TheMahaanOne/fsae-aero-2026/images/cfd/volume_mesh_side.jpg

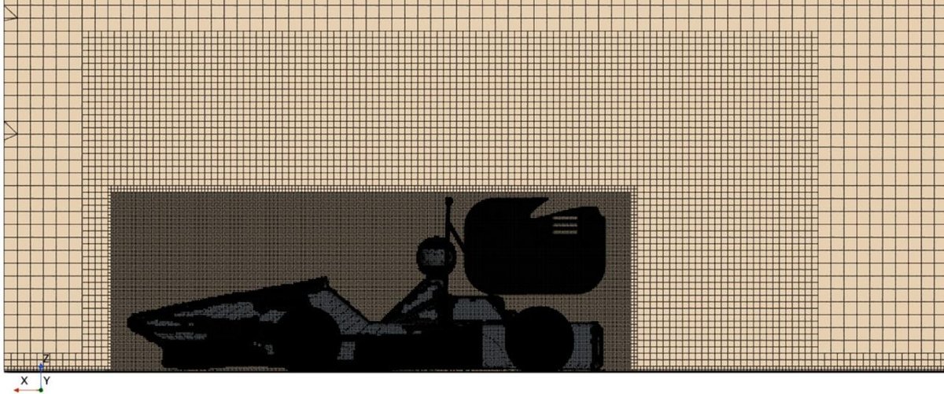
images/cfd/volume_mesh_side.jpg
