TheMahaanOne/fsae-aero-2026/images/rear_wing_corrugated_element.jpg

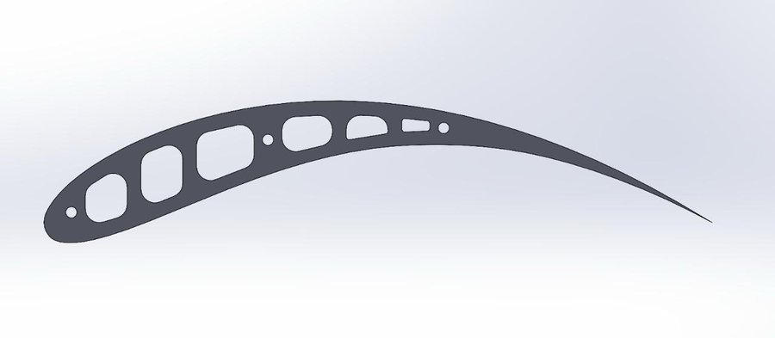
images/rear_wing_corrugated_element.jpg
