TheMahaanOne/fsae-aero-2026/images/sweeps/front_wing_cd_pitch.jpg

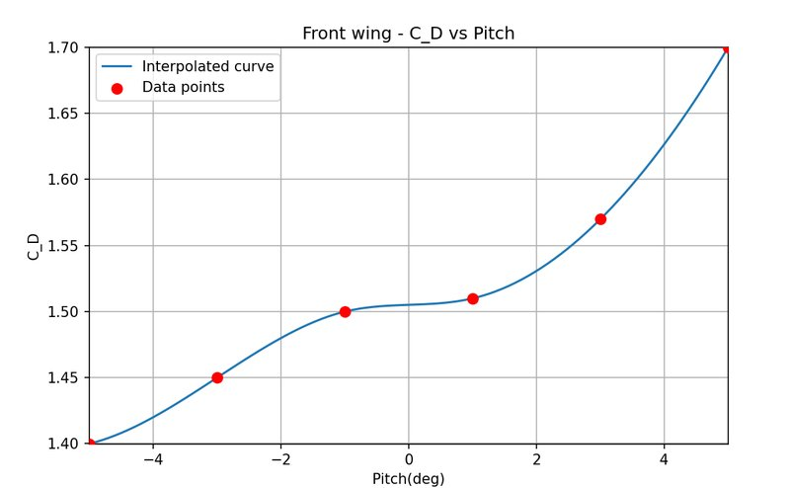
images/sweeps/front_wing_cd_pitch.jpg
