TheMahaanOne/fsae-aero-2026/cad/full_car.stl

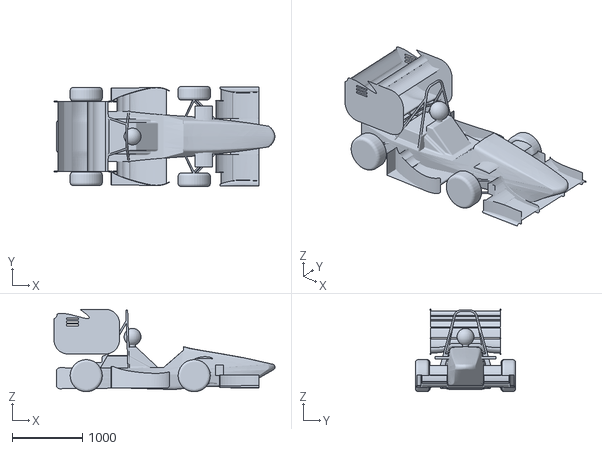
[picture p39: CAD file, 2026-10-17]
cad/full_car.stl
3136.6 x 1420.0 x 1170.0
