TheMahaanOne/fsae-aero-2026/cad/side_wings.stl

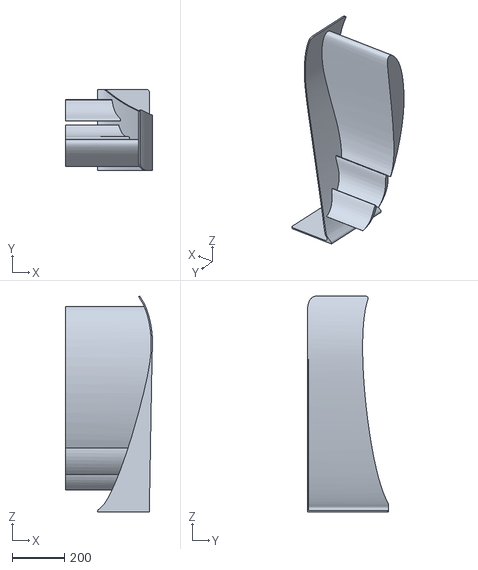
[picture p40: CAD file, 2026-10-17]
cad/side_wings.stl
332.7 x 310.0 x 825.1
