TheMahaanOne/fsae-aero-2026/cad/bluff_body.stl

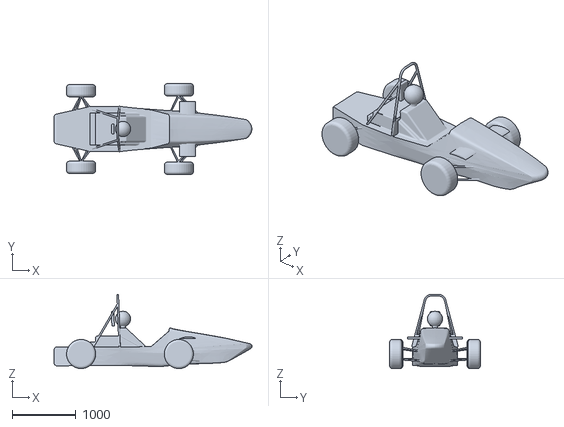
[picture p41: CAD file, 2026-10-17]
cad/bluff_body.stl
3103.6 x 1420.0 x 1162.0
