TheMahaanOne/fsae-aero-2026/cad/rear_wing.stl

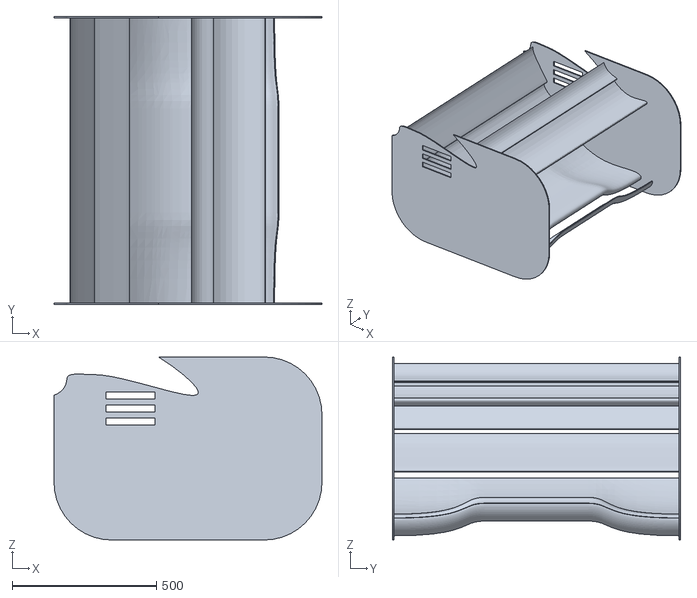
[picture p42: CAD file, 2026-10-17]
cad/rear_wing.stl
930.0 x 1000.0 x 635.0
