TheMahaanOne/fsae-aero-2026/cad/front_wing.stl

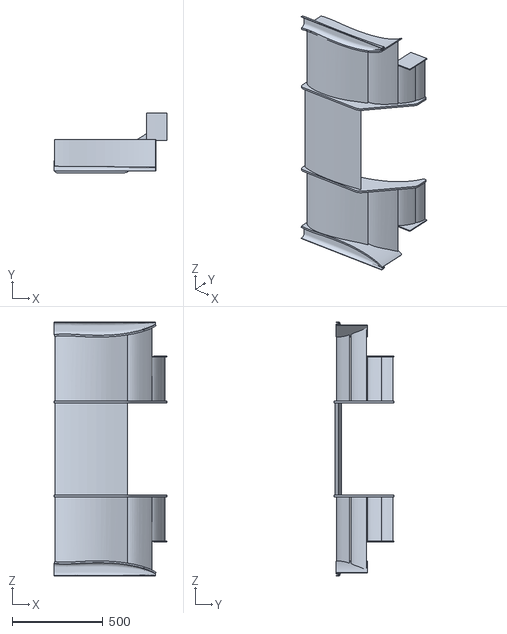
[picture p43: CAD file, 2026-10-17]
cad/front_wing.stl
621.5 x 330.0 x 1400.6
