TheMahaanOne/fsae-aero-2026/(list of files, cad)

Other CAD files:
cad/bluff_body.x_t
cad/front_wing.x_t
cad/full_car.x_t
cad/rear_wing.x_t
cad/side_wings.x_t
