TheMahaanOne/fsae-aero-2026/images/manufacturing/female_mould_for_front_wing_flaps.jpg

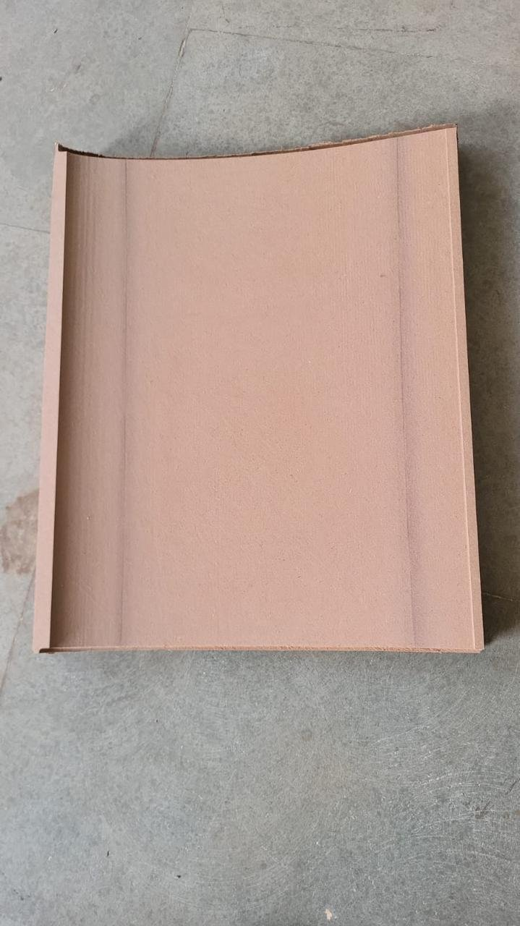
images/manufacturing/female_mould_for_front_wing_flaps.jpg
