TheMahaanOne/fsae-aero-2026/images/manufacturing/filler_and_putty_to_smoothen_female_mould_2.jpg

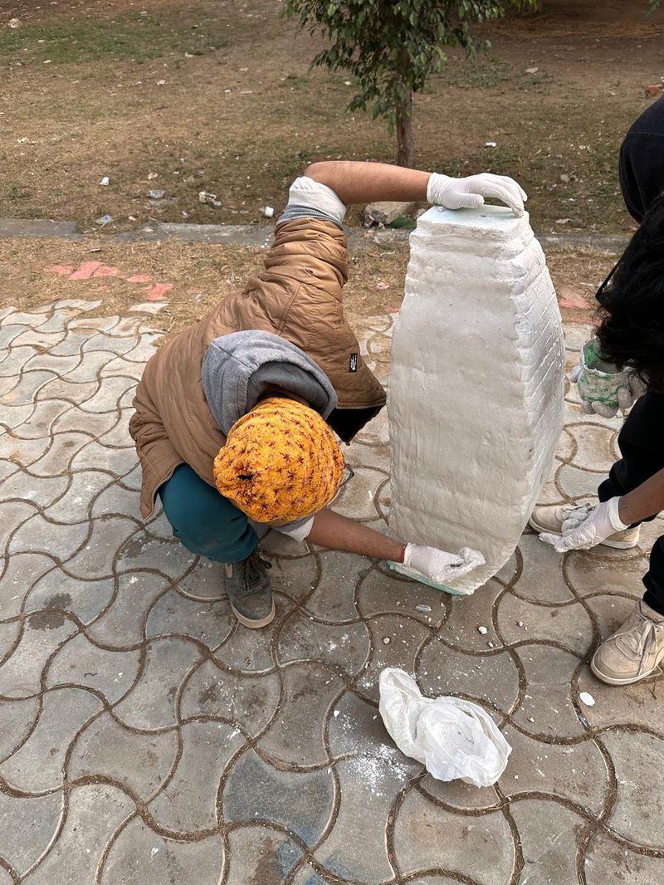
images/manufacturing/filler_and_putty_to_smoothen_female_mould_2.jpg
