TheMahaanOne/fsae-aero-2026/images/manufacturing/final_nosecone_pattern.jpg

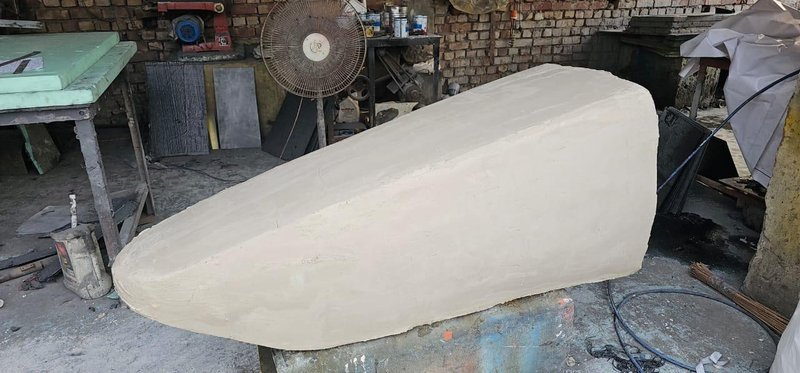
images/manufacturing/final_nosecone_pattern.jpg
