TheMahaanOne/fsae-aero-2026/images/manufacturing/vacuum_drawn_checking_for_leaks.jpg

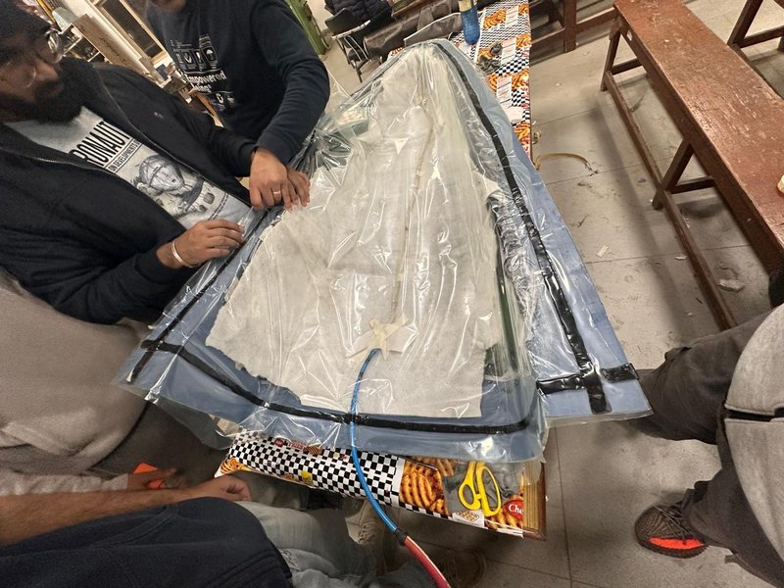
images/manufacturing/vacuum_drawn_checking_for_leaks.jpg
