TheMahaanOne/fsae-aero-2026/images/car/in_the_workshop_between_testing.jpg

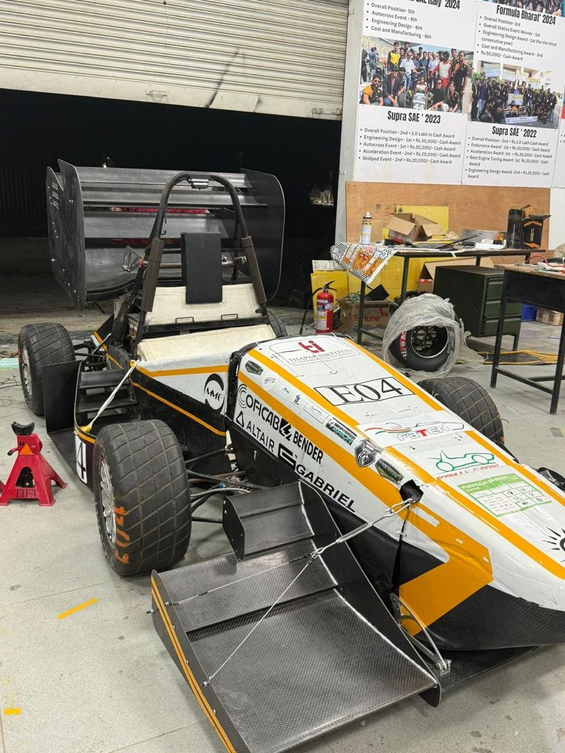
images/car/in_the_workshop_between_testing.jpg
