TheMahaanOne/fsae-aero-2026/images/manufacturing/test_fitting.jpg

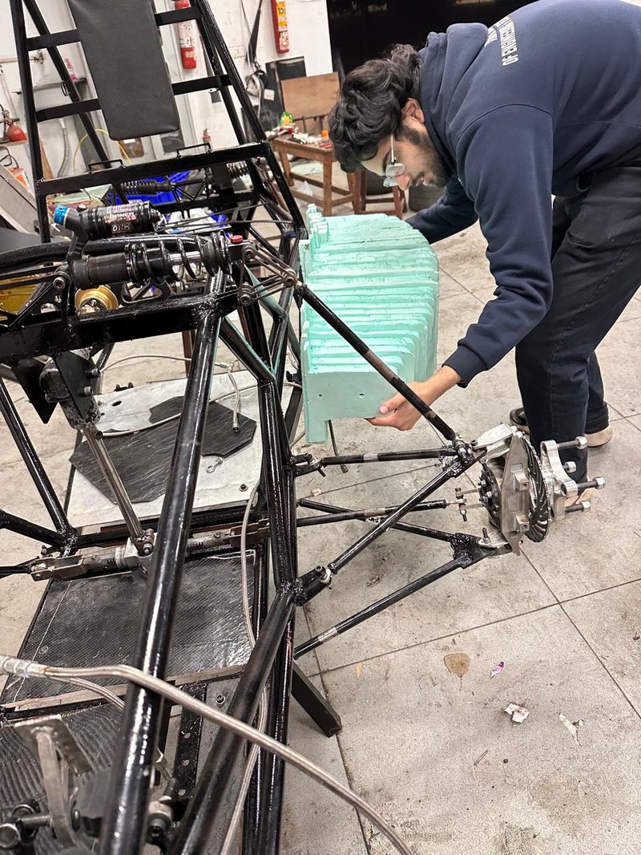
images/manufacturing/test_fitting.jpg
